sarunia/ESP32_radio_player_v2/ESP32_radio_v2/Schematic and Arduino IDE settings/OLED display SSD1322 256x64 rear.png

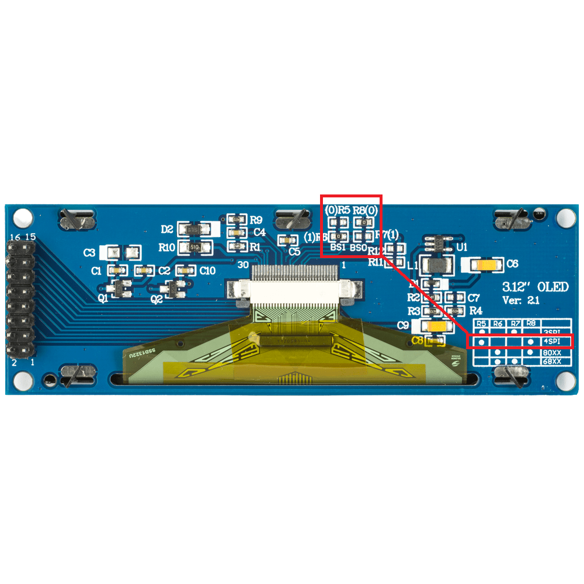
ESP32_radio_v2/Schematic and Arduino IDE settings/OLED display SSD1322 256x64 rear.png
