sarunia/ESP32_radio_player_v2/ESP32_radio_v2/Schematic and Arduino IDE settings/Zestawienie materiałów użytych w projekcie.pdf

OPIS MODUŁU | ILOŚĆ | CENA | LINK
1. WYŚWIETLACZ OLED 3,12 CALA | 1 | 80,00 zł | https://sklep.msalamon.pl/produkt/wyswietlacz-oled-312-256x64px-bialy/
2. MODUŁ ESP32-S3-DEVKIT, ESP32-S3-WROOM-1-N16R8 WiFi | 1 | 44,00 zł | https://sklep.msalamon.pl/produkt/plytka-esp32-esp32-s3-devkit-wifi-ble-5-0/
3. PRZETWORNIK DAC PCM5102A | 1 | 15,00 zł | https://sklep.msalamon.pl/produkt/modul-dekodera-dac-pcm5102a-i2s/
4. CZYTNIK KART MIKRO SD | 1 | 6,00 zł | https://sklep.msalamon.pl/produkt/modul-czytnika-kart-micro-sd/
5. ENKODER OBROTOWY Z PRZYCISKIEM | 2 | 10,00 zł | https://sklep.msalamon.pl/produkt/enkoder-impulsator-obrotowy/
6. JOYSTICK 4 KIERUNKOWY Z PRZYCISKIEM | 1 | 7,00 zł | https://sklep.msalamon.pl/produkt/modul-3-osiowy-joystick-analogowy/
7. PŁYTKA STYKOWA | 1 | 14,00 zł | https://sklep.msalamon.pl/produkt/plytka-stykowa-830-pol-biala/
8. PRZEWODY POŁĄCZENIOWE ŻEŃSKO-ŻEŃSKIE | 1 | 8,00 zł | https://sklep.msalamon.pl/produkt/przewody-polaczeniowe-20cm-40szt-zensko-zenskie/
9. PRZEWODY POŁĄCZENIOWE ŻEŃSKO-MĘSKIE | 1 | 8,00 zł | https://sklep.msalamon.pl/produkt/przewody-polaczeniowe-20cm-40szt-zensko-meskie/
10. ZASILACZ DO PŁYTKI STYKOWEJ MB102 | 1 | 6,00 zł | https://sklep.msalamon.pl/produkt/modul-zasilania-do-plytek-stykowych-mb102-33v-5v/
11. MODUŁ ODBIORNIKA PODCZERWIENI | 1 | 6,00 zł | https://sklep.msalamon.pl/produkt/modul-odbiornika-podczerwieni-ir-38khz/
12. PILOT ZDALNEGO STEROWANIA IR | 1 | 7,00 zł | https://sklep.msalamon.pl/produkt/pilot-ir-uniwersalny-20-przyciskow/
13. OBUDOWA GAINTA G748 | 1 | 58,00 zł | https://www.tme.eu/pl/details/g748/obudowy-z-panelem/gainta/
14. PŁYTKA NA ZAMÓWIENIE WG WŁASNEGO PROJEKTU PCB | 1 | 110,00 zł | zamówienie z Satland Prototype, zamiast płytki stykowej / prototypowej
15. GAŁKI NA ENKODERY, GNIAZDA GOLDPIN, ZŁĄCZA GOLDPIN | KOMPLET | 20,00 zł | zamówione w TME
SUMA | | 399,00 zł
