sarunia/ESP32_radio_player_v2/ESP32_radio_v2/Pictures/20241208_135752.jpg

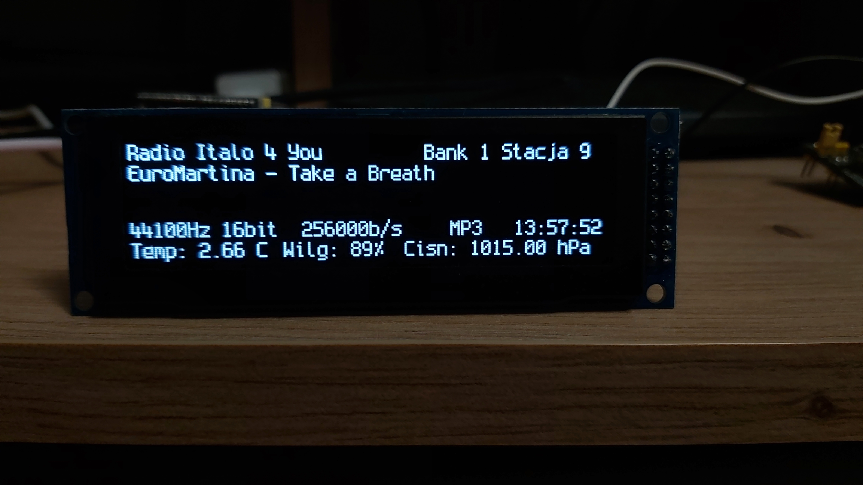
ESP32_radio_v2/Pictures/20241208_135752.jpg
