sarunia/ESP32_radio_player_v2/ESP32_radio_v2/Pictures/20241229_203728.jpg

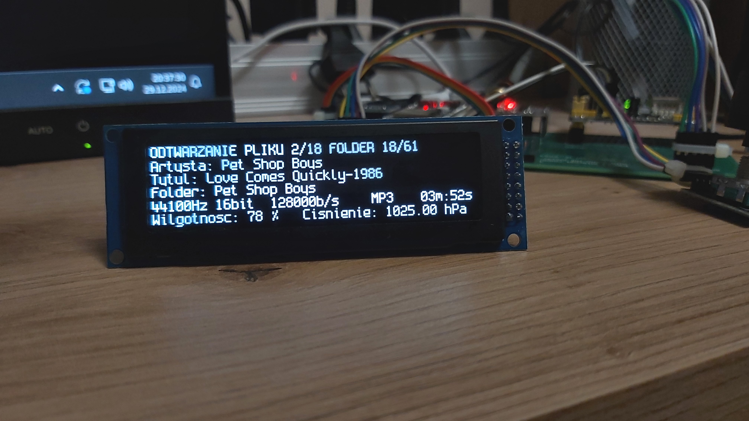
ESP32_radio_v2/Pictures/20241229_203728.jpg
