sarunia/ESP32_radio_player_v2/ESP32_radio_v2/Pictures/20250108_183221.jpg

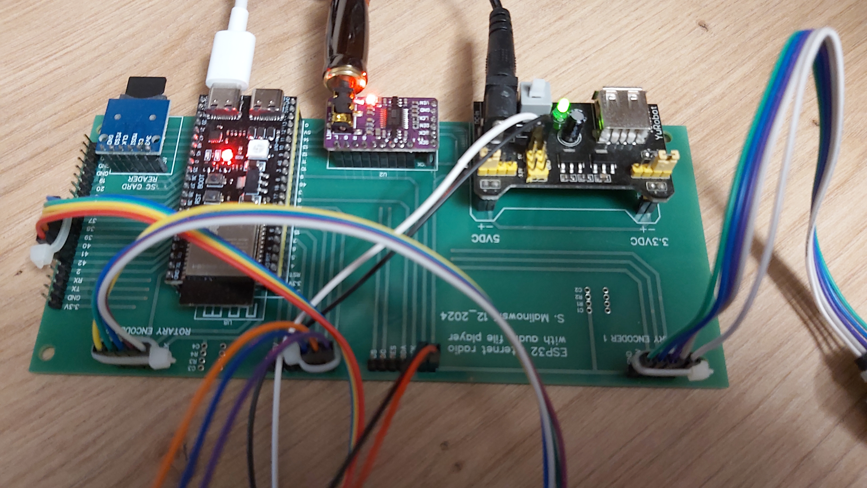
ESP32_radio_v2/Pictures/20250108_183221.jpg
