sarunia/ESP32_radio_player_v2/ESP32_radio_v2/Pictures/20250603_185507.jpg

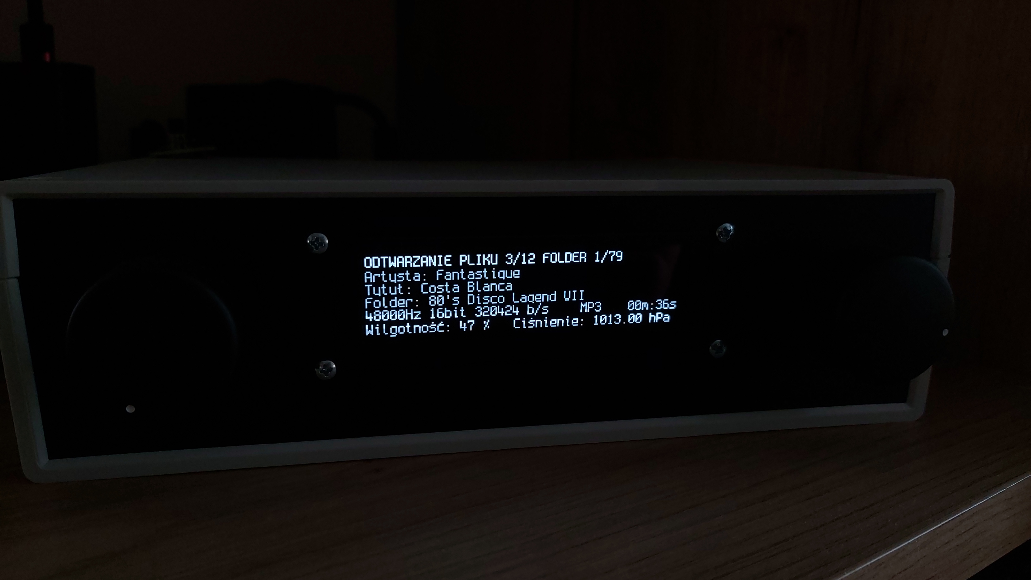
ESP32_radio_v2/Pictures/20250603_185507.jpg
