sarunia/ESP32_radio_player_v2/ESP32_radio_v2/Schematic and Arduino IDE settings/Schematic_ESP32-internet-radio_v2.pdf

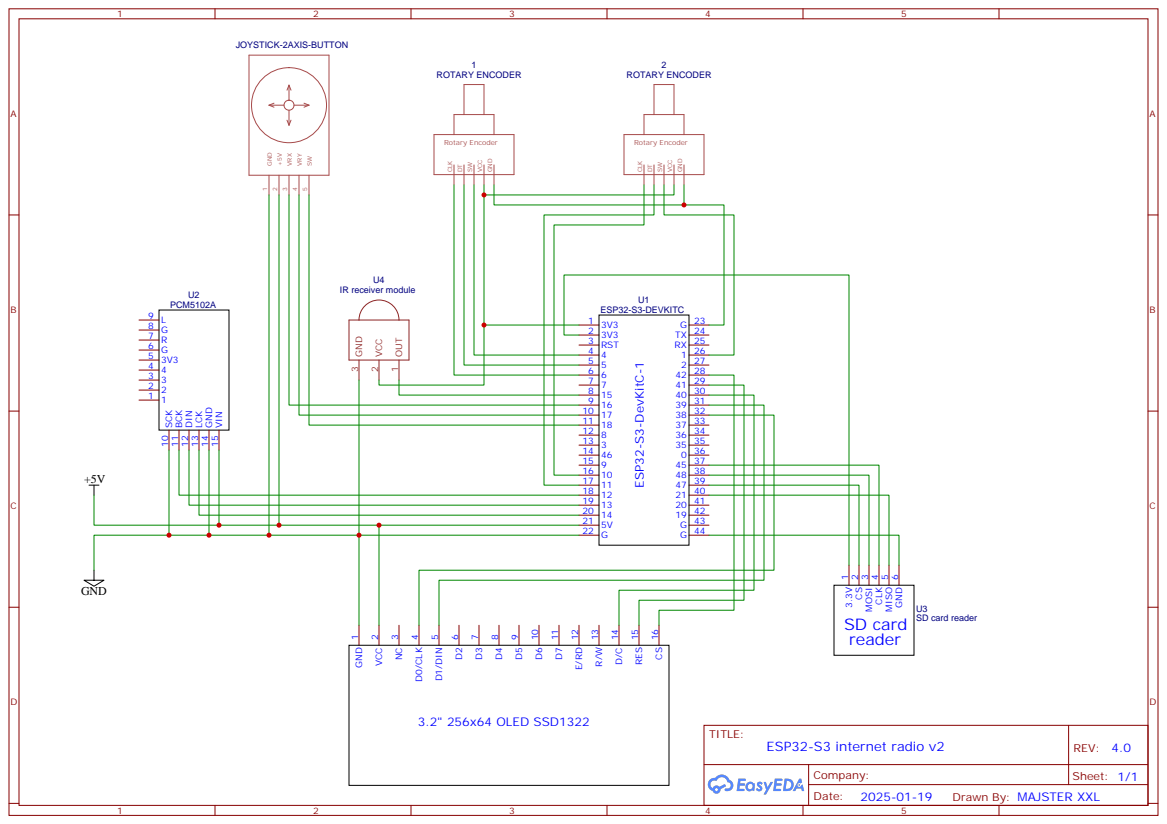
[picture p14: page 1]

Drawn By: MAJSTER XXL
