sarunia/ESP32_radio_player_v2/ESP32_radio_v2/Schematic and Arduino IDE settings/PCB_PCB_ESP32-internet-radio-v2_2025-01-07.pdf

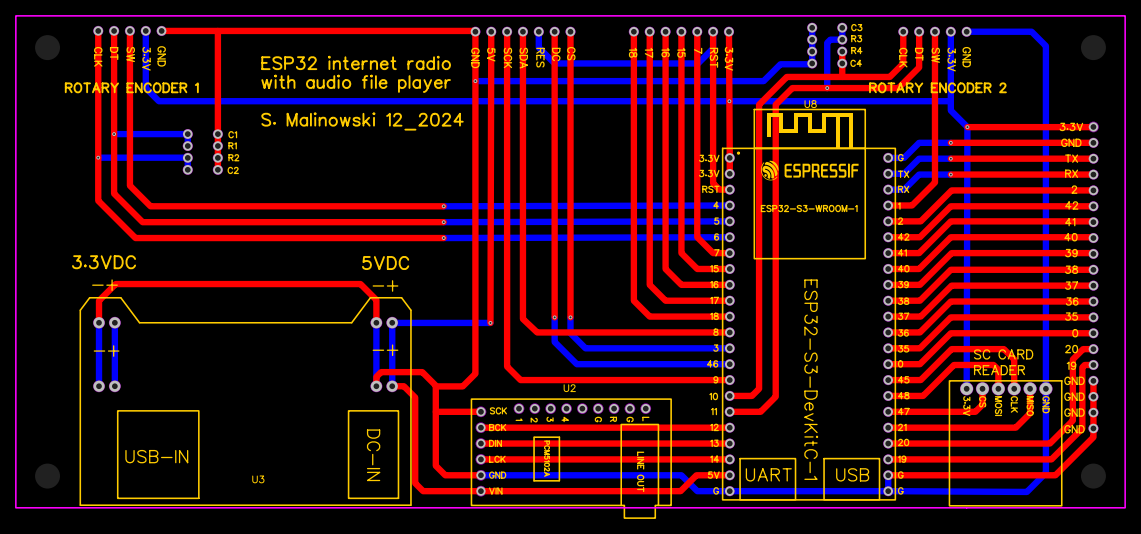
[picture p15: page 1]
